atomicra1n/stylus-synth/images/render.png

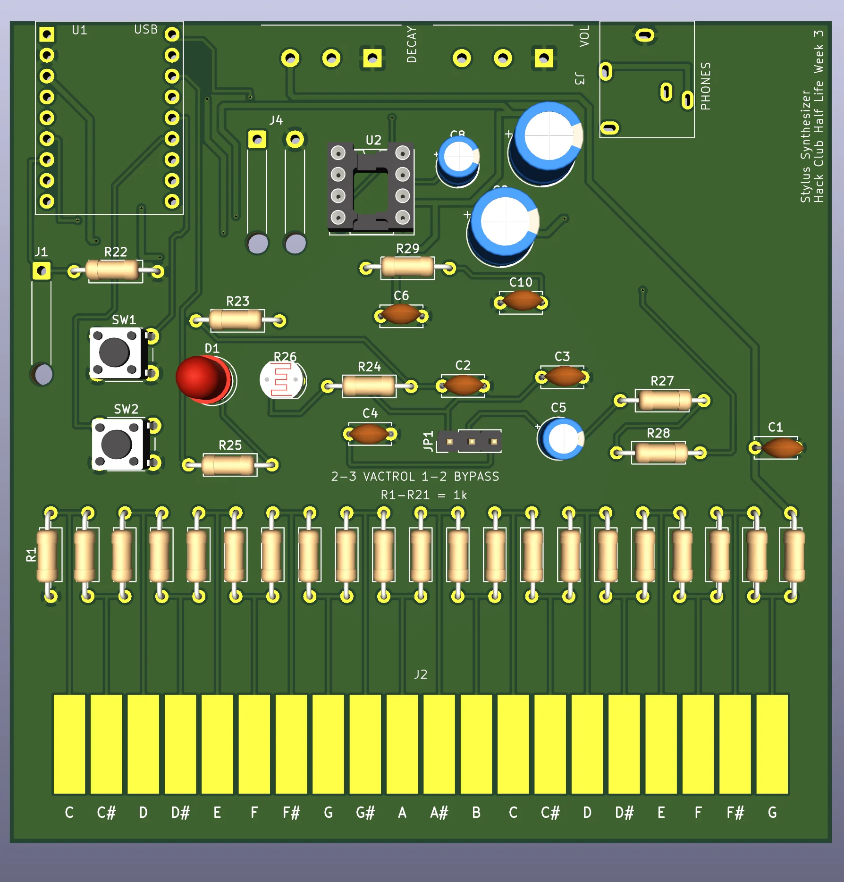
images/render.png
