atomicra1n/stylus-synth/images/pcb.png

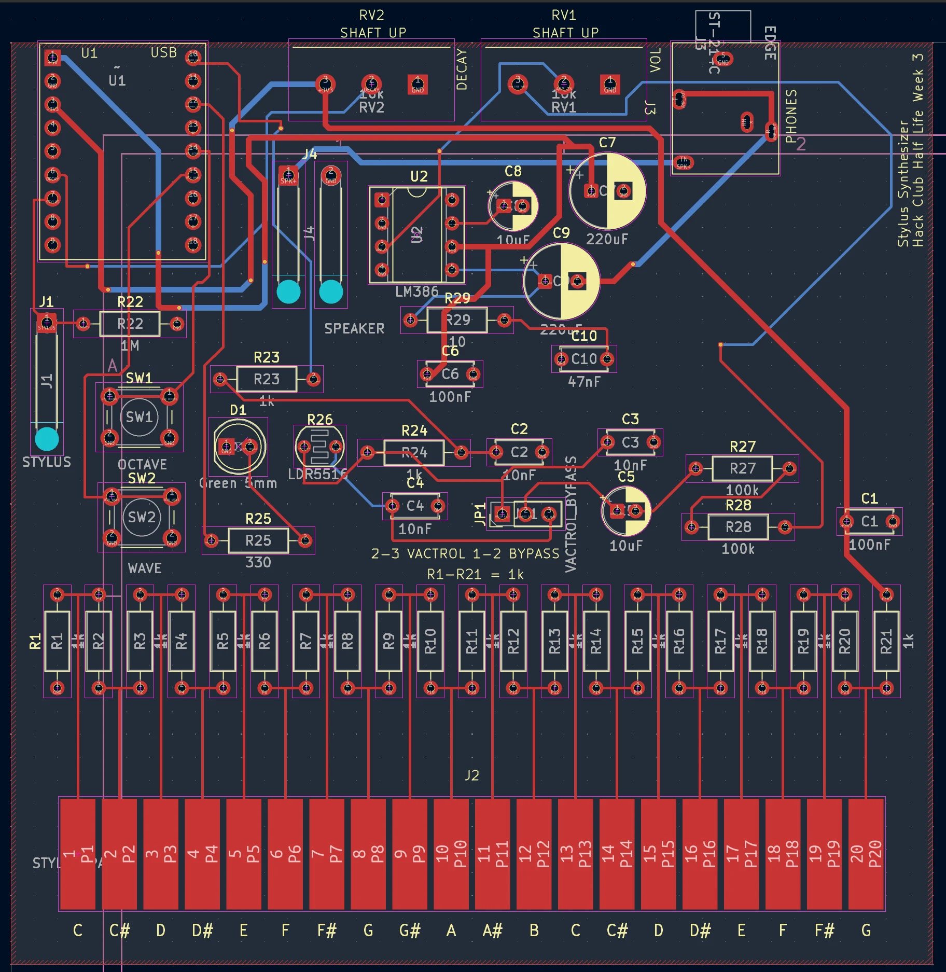
images/pcb.png
