atomicra1n/stylus-synth/images/falstad1.png

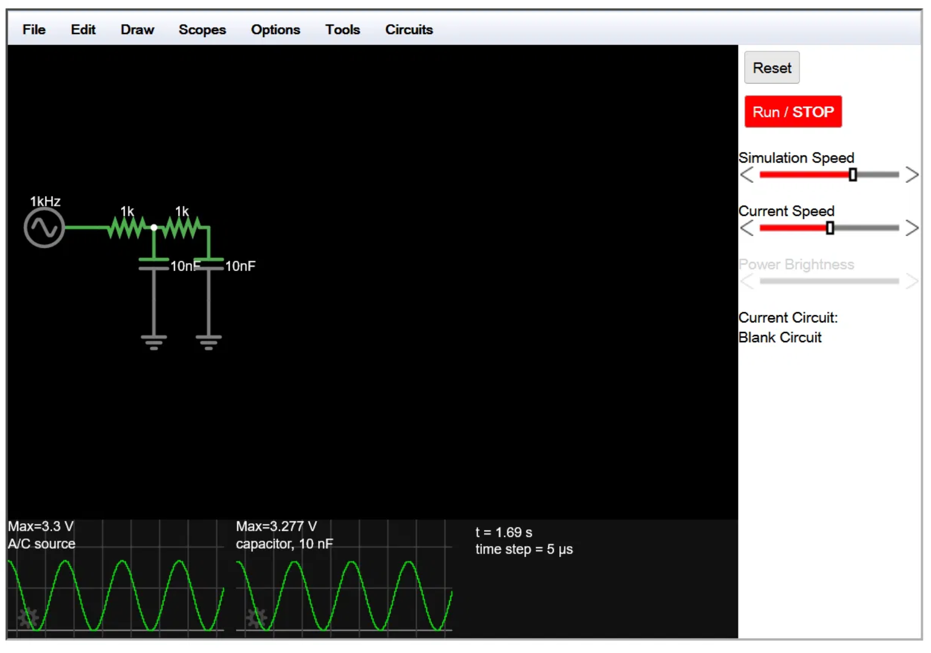
images/falstad1.png
