atomicra1n/stylus-synth/images/falstad2.png

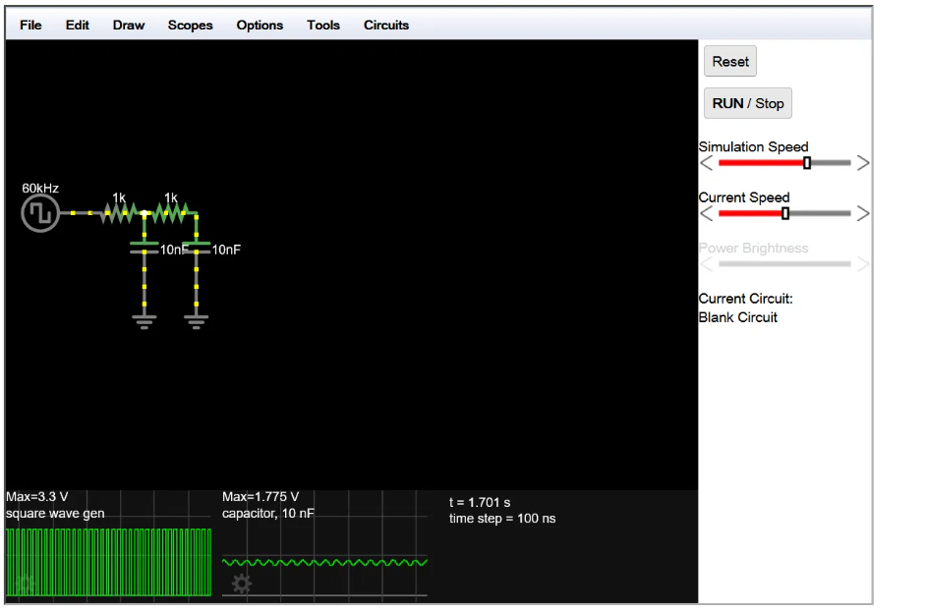
images/falstad2.png
