atomicra1n/stylus-synth/images/falstad3.png

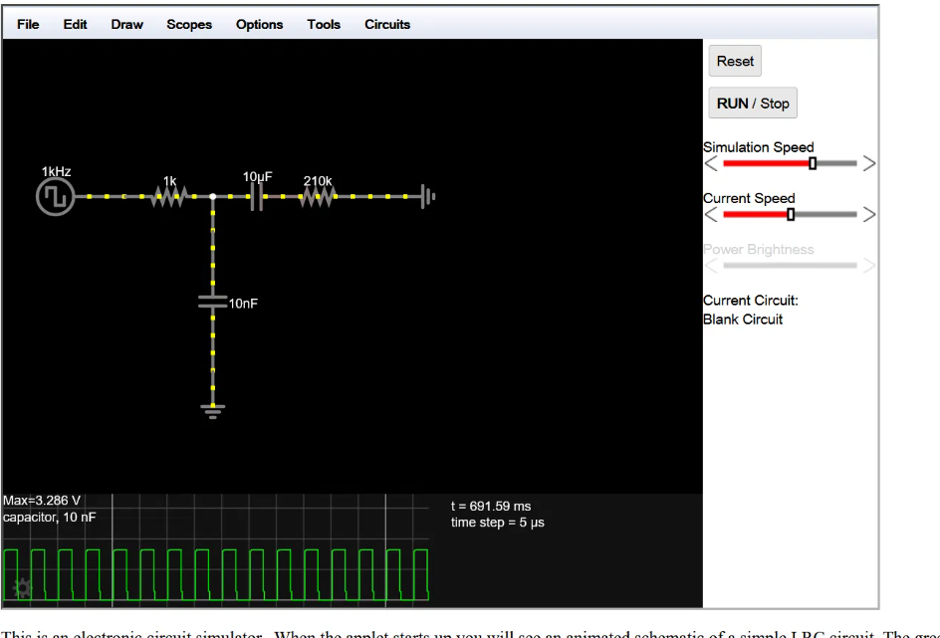
images/falstad3.png
