atomicra1n/stylus-synth/images/falstad4.png

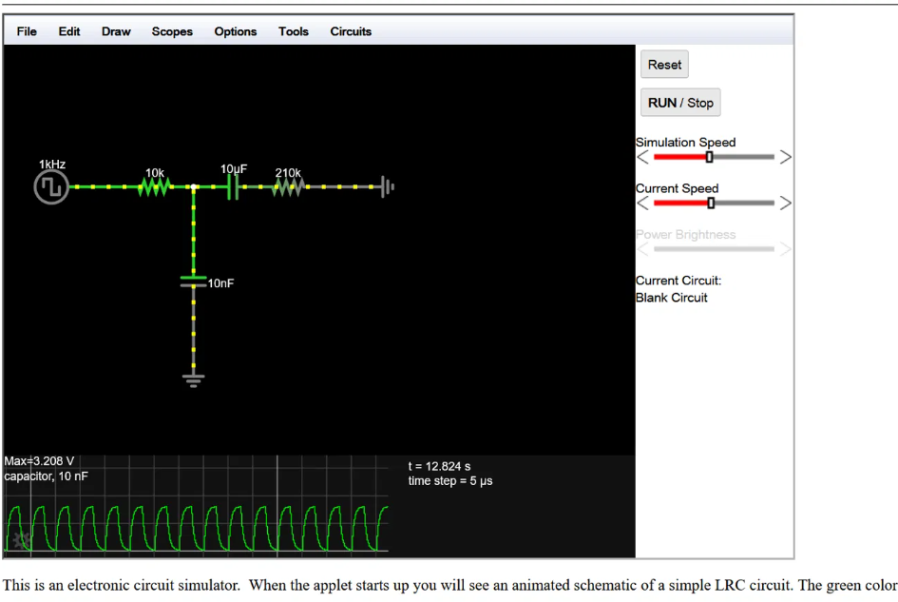
images/falstad4.png
