atomicra1n/stylus-synth/images/falstad5.png

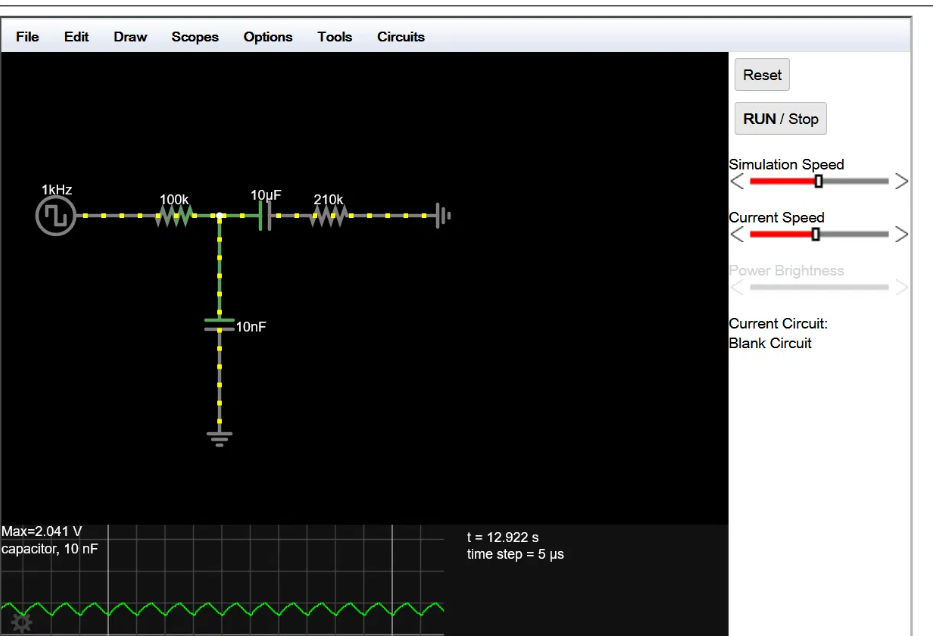
images/falstad5.png
