atomicra1n/stylus-synth/images/falstad7.png

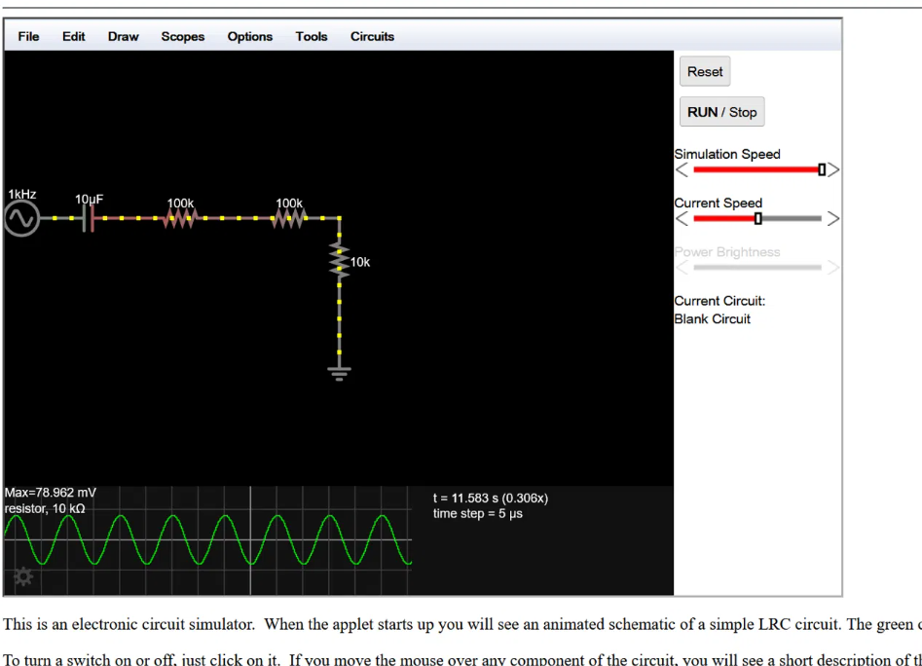
images/falstad7.png
