atomicra1n/stylus-synth/images/schematic.png

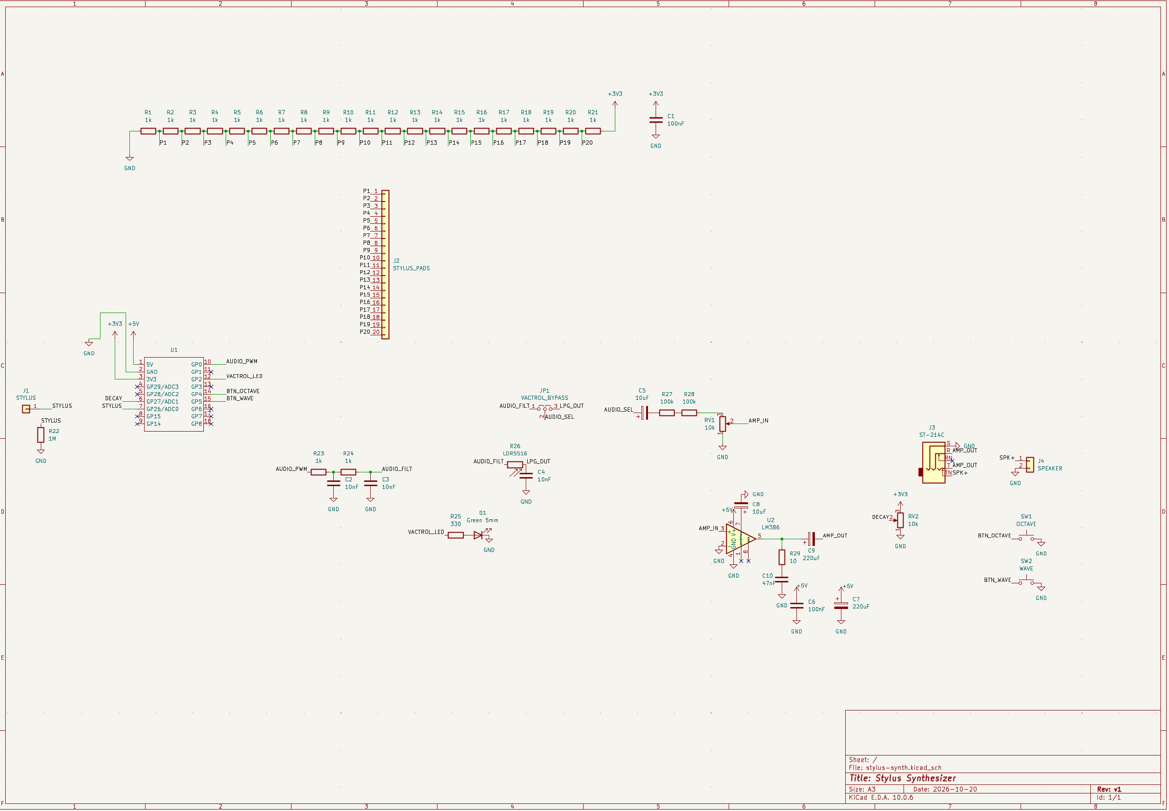
images/schematic.png
