atomicra1n/stylus-synth/pcb/stylus-synth.kicad_pcb

## KiCad design pcb/stylus-synth.kicad_pcb (2026-10-23)

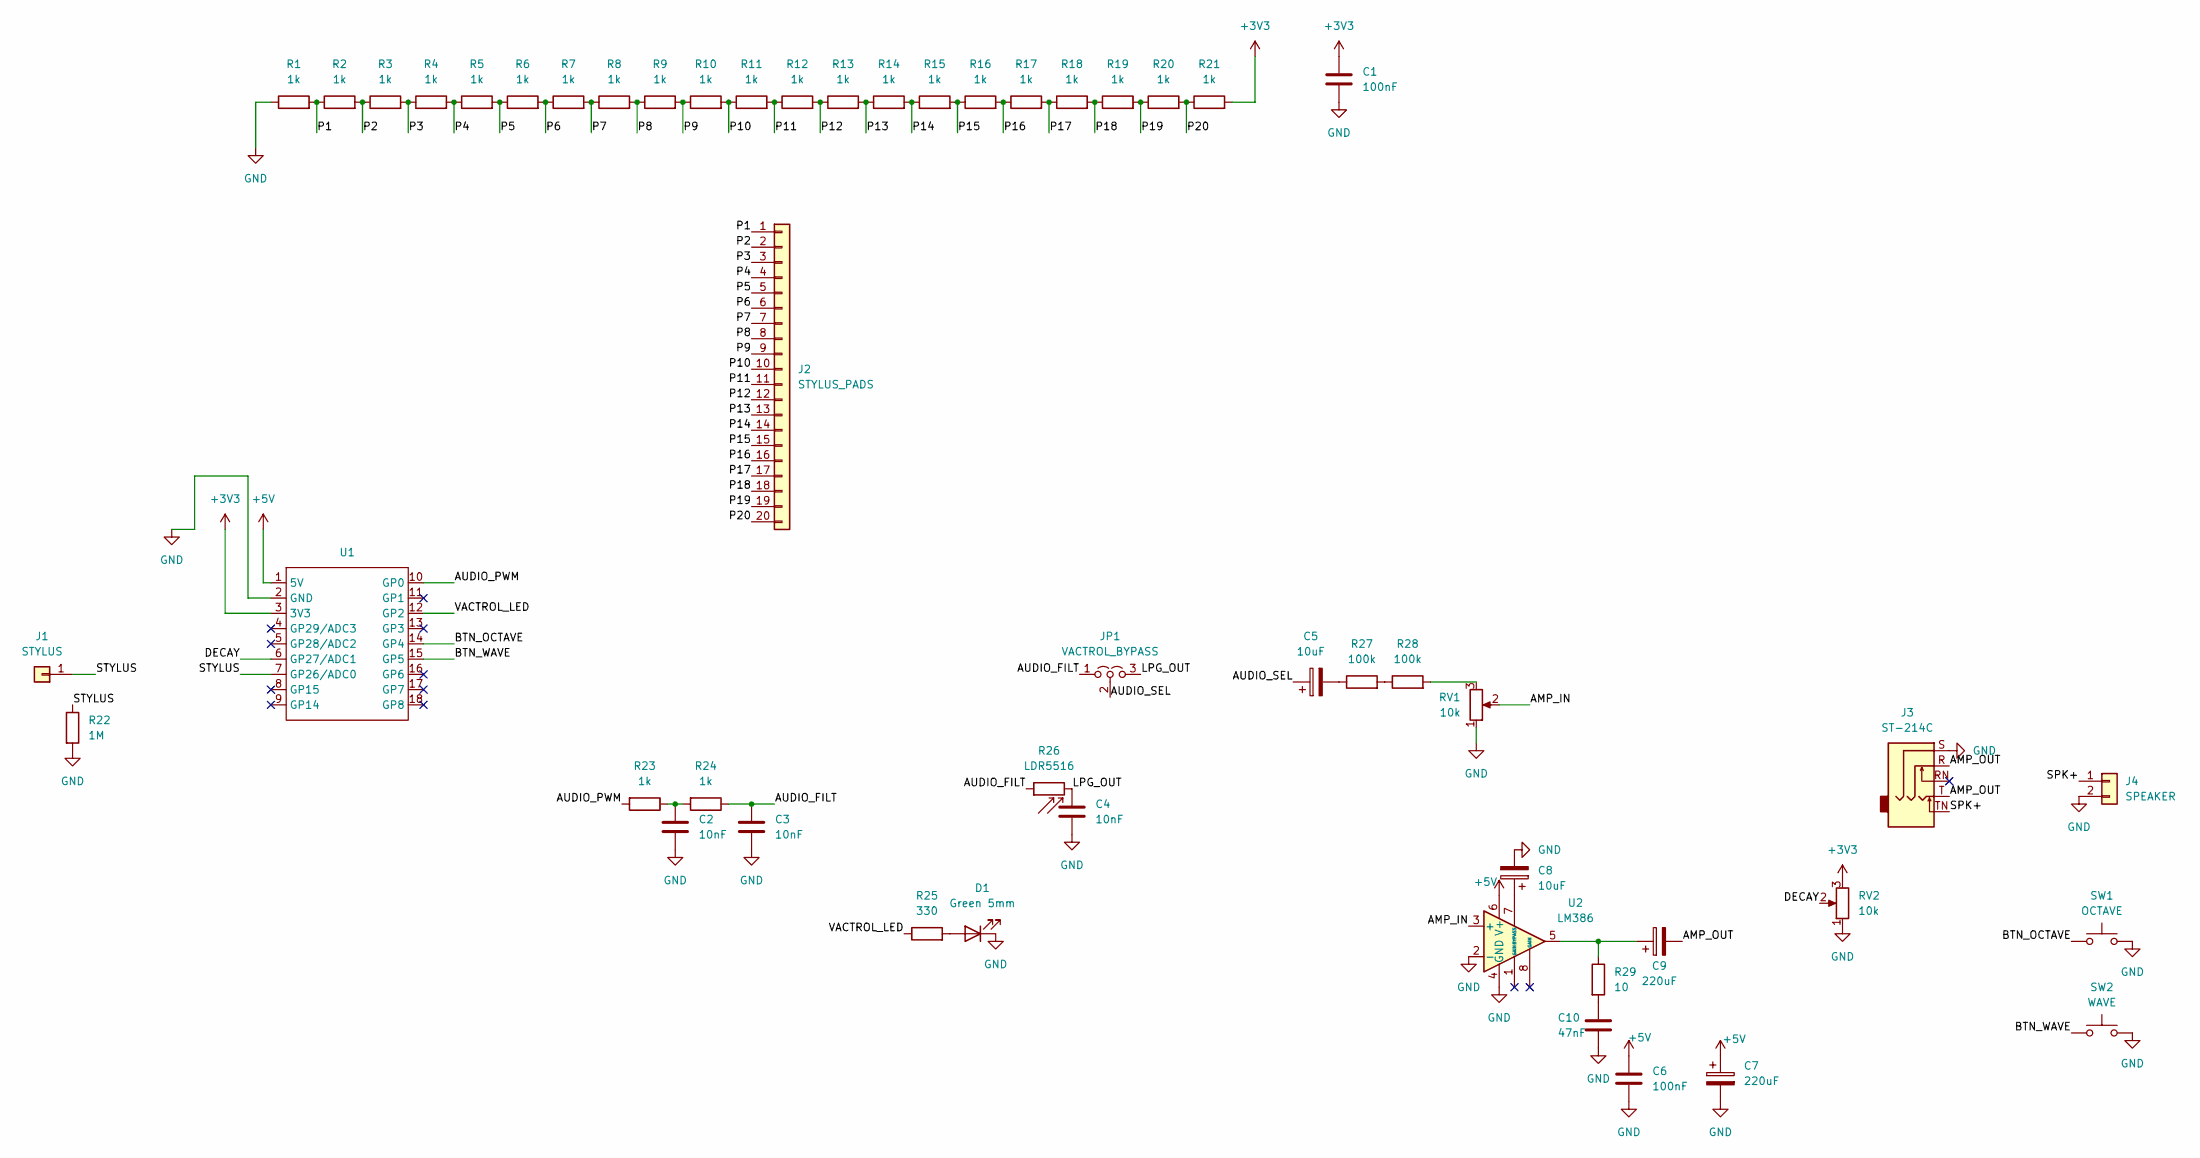
[picture p10: schematic stylus-synth.kicad_sch, Stylus Synthesizer]

Parts:
C1, C6: 100nF; C_Disc_D5.0mm_W2.5mm_P5.00mm
C2, C3, C4: 10nF; C_Disc_D5.0mm_W2.5mm_P5.00mm
C5, C8: 10uF; CP_Radial_D5.0mm_P2.00mm
C7, C9: 220uF; CP_Radial_D8.0mm_P3.50mm
C10: 47nF; C_Disc_D5.0mm_W2.5mm_P5.00mm
D1: Green 5mm; LED_D5.0mm
J1: STYLUS; SolderWire-0.5sqmm_1x01_D0.9mm_OD2.1mm_Relief
J2: STYLUS_PADS; StylusPads_20x4.5mm
J3: ST-214C; Jack_3.5mm_ST-214C
J4: SPEAKER; SolderWire-0.5sqmm_1x02_P4.6mm_D0.9mm_OD2.1mm_Relief
JP1: VACTROL_BYPASS; PinHeader_1x03_P2.54mm_Vertical
R1, R2, R3, R4, R5, R6, R7, R8, R9, R10, R11, R12, R13, R14, R15, R16, R17, R18, R19, R20, R21, R23, R24: 1k; R_Axial_DIN0207_L6.3mm_D2.5mm_P10.16mm_Horizontal
R22: 1M; R_Axial_DIN0207_L6.3mm_D2.5mm_P10.16mm_Horizontal
R25: 330; R_Axial_DIN0207_L6.3mm_D2.5mm_P10.16mm_Horizontal
R26: LDR5516; R_LDR_5.1x4.3mm_P3.4mm_Vertical
R27, R28: 100k; R_Axial_DIN0207_L6.3mm_D2.5mm_P10.16mm_Horizontal
R29: 10; R_Axial_DIN0207_L6.3mm_D2.5mm_P10.16mm_Horizontal
RV1, RV2: 10k; Pot_WH148_RightAngle
SW1: OCTAVE; SW_PUSH_6mm
SW2: WAVE; SW_PUSH_6mm
U1: RP2040-Zero
U2: LM386; DIP-8_W7.62mm_Socket

Connections:
+3V3: C1.1, R21.2, RV2.3, U1.3 (3V3)
+5V: C6.1, C7.1, U1.1 (5V), U2.6 (V+)
/AMP_IN: RV1.2, U2.3 (+)
/AMP_OUT: C9.2, J3.R, J3.T
/AUDIO_FILT: C3.1, JP1.1 (A), R24.1, R26.1
/AUDIO_PWM: R23.2, U1.10 (GP0)
/AUDIO_SEL: C5.1, JP1.2 (C)
/BTN_OCTAVE: SW1.1, U1.14 (GP4)
/BTN_WAVE: SW2.1, U1.15 (GP5)
/DECAY: RV2.2, U1.6 (GP27/ADC1)
/LPG_OUT: C4.1, JP1.3 (B), R26.2
/P1: J2.1, R1.2, R2.1
/P2: J2.2, R2.2, R3.1
/P3: J2.3, R3.2, R4.1
/P4: J2.4, R4.2, R5.1
/P5: J2.5, R5.2, R6.1
/P6: J2.6, R6.2, R7.1
/P7: J2.7, R7.2, R8.1
/P8: J2.8, R8.2, R9.1
/P9: J2.9, R9.2, R10.1
/P10: J2.10, R10.2, R11.1
/P11: J2.11, R11.2, R12.1
/P12: J2.12, R12.2, R13.1
/P13: J2.13, R13.2, R14.1
/P14: J2.14, R14.2, R15.1
/P15: J2.15, R15.2, R16.1
/P16: J2.16, R16.2, R17.1
/P17: J2.17, R17.2, R18.1
/P18: J2.18, R18.2, R19.1
/P19: J2.19, R19.2, R20.1
/P20: J2.20, R20.2, R21.1
/SPK+: J3.TN, J4.1
/STYLUS: J1.1 (Pin_1_1), R22.1, U1.7 (GP26/ADC0)
/VACTROL_LED: R25.1, U1.12 (GP2)
GND: C1.2, C2.2, C3.2, C4.2, C6.2, C7.2, C8.2, C10.1, D1.1 (K), J3.S, J4.2, R1.1, R22.2, RV1.1, RV2.1, SW1.2, SW2.2, U1.2 (GND), U2.2 (-), U2.4 (GND)
unnamed: C2.1, R23.1, R24.2
unnamed: C5.2, R27.1
unnamed: C9.1, R29.1, U2.5
unnamed: C10.2, R29.2
unnamed: D1.2 (A), R25.2
unnamed: R27.2, R28.1
unnamed: R28.2, RV1.3
unnamed: C8.1, U2.7 (BYPASS)

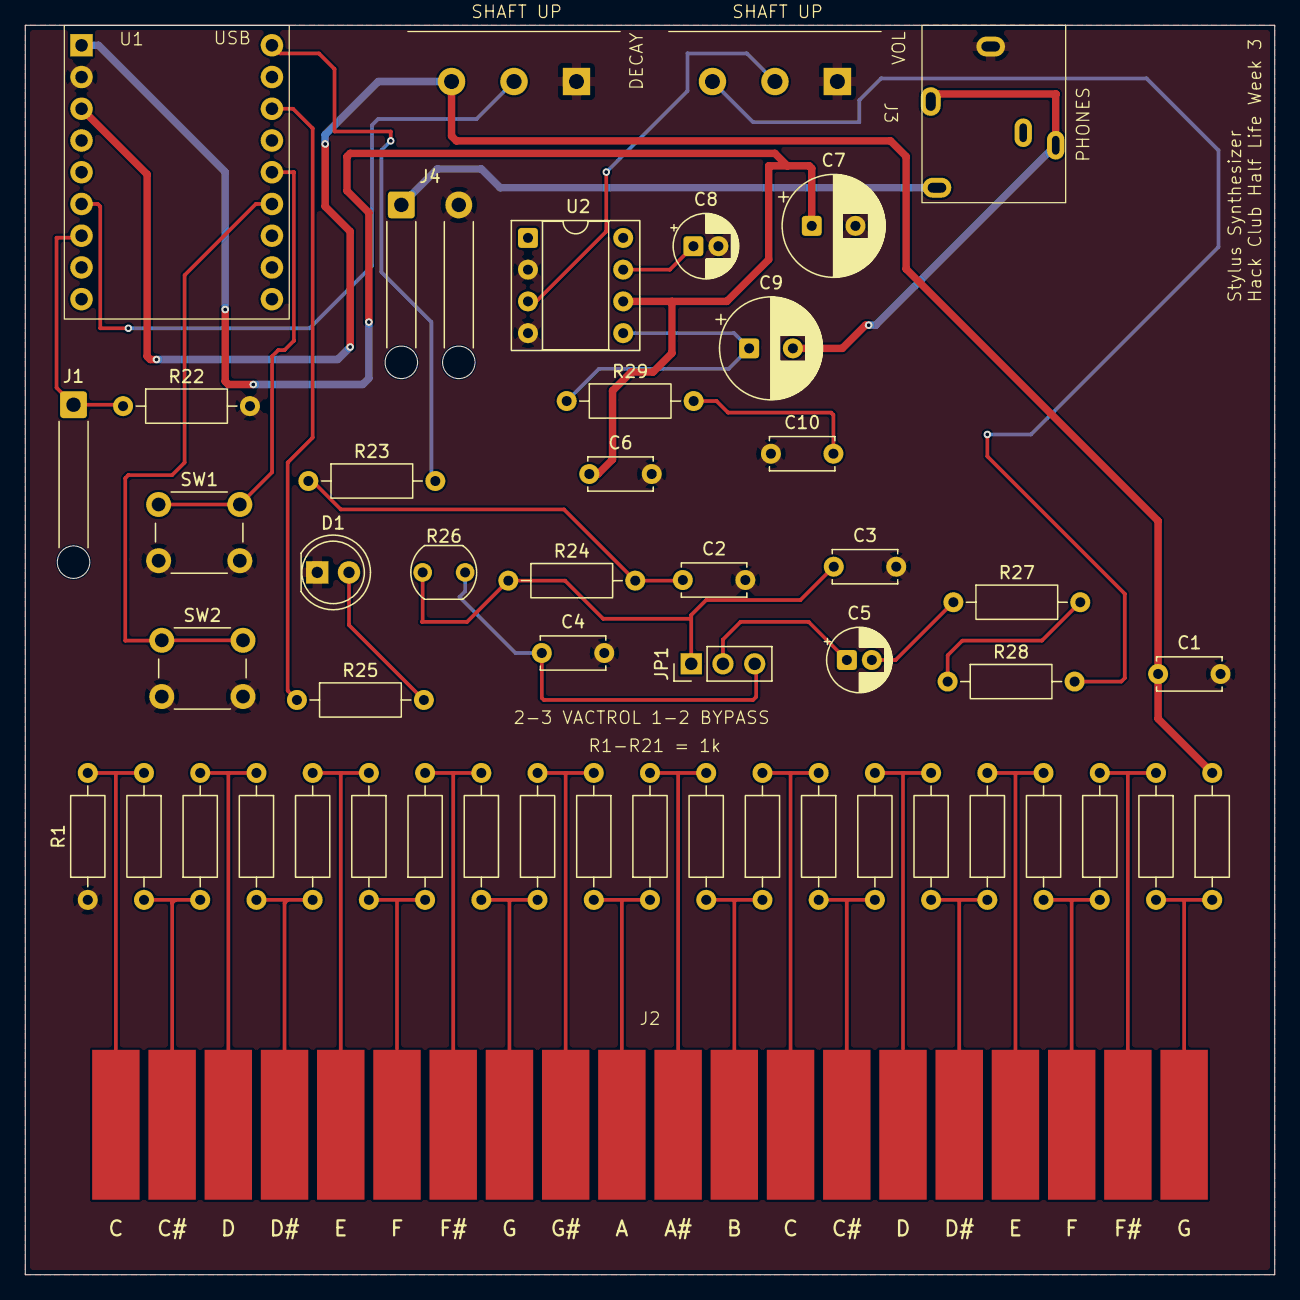
[picture p11: board stylus-synth.kicad_pcb from above]

Board: 2 copper layers, 100.0 x 100.0 mm, 51 parts (0 on the bottom side), 43 nets.
