atomicra1n/stylus-synth/(commit log)

2026-10-22 Add footprints and full schematic
    [stylus-synth.kicad_pcb, stylus-synth.kicad_sch]
2026-10-22 Footprints, board layout and basic routing
    [stylus-synth.kicad_pcb, stylus-synth.kicad_sch]
2026-10-23 Finish PCB routing, add ground pour, export Gerbers
    [stylus-synth-B_Cu.gbl, stylus-synth-B_Mask.gbs, stylus-synth-B_Silkscreen.gbo, stylus-synth-Edge_Cuts.gm1, stylus-synth-F_Cu.gtl, stylus-synth-F_Mask.gts, stylus-synth-F_Silkscreen.gto, stylus-synth-NPTH.drl]
2026-10-24 Sync Stylus Synthesizer from Half Life
    [BOM.csv]
2026-10-24 add waveforms, buttons and decay to firmware
